OpenMUPP/openmupp-v1/openmupp-v1.kicad_pcb

## KiCad design openmupp-v1.kicad_pcb (2026-11-05)

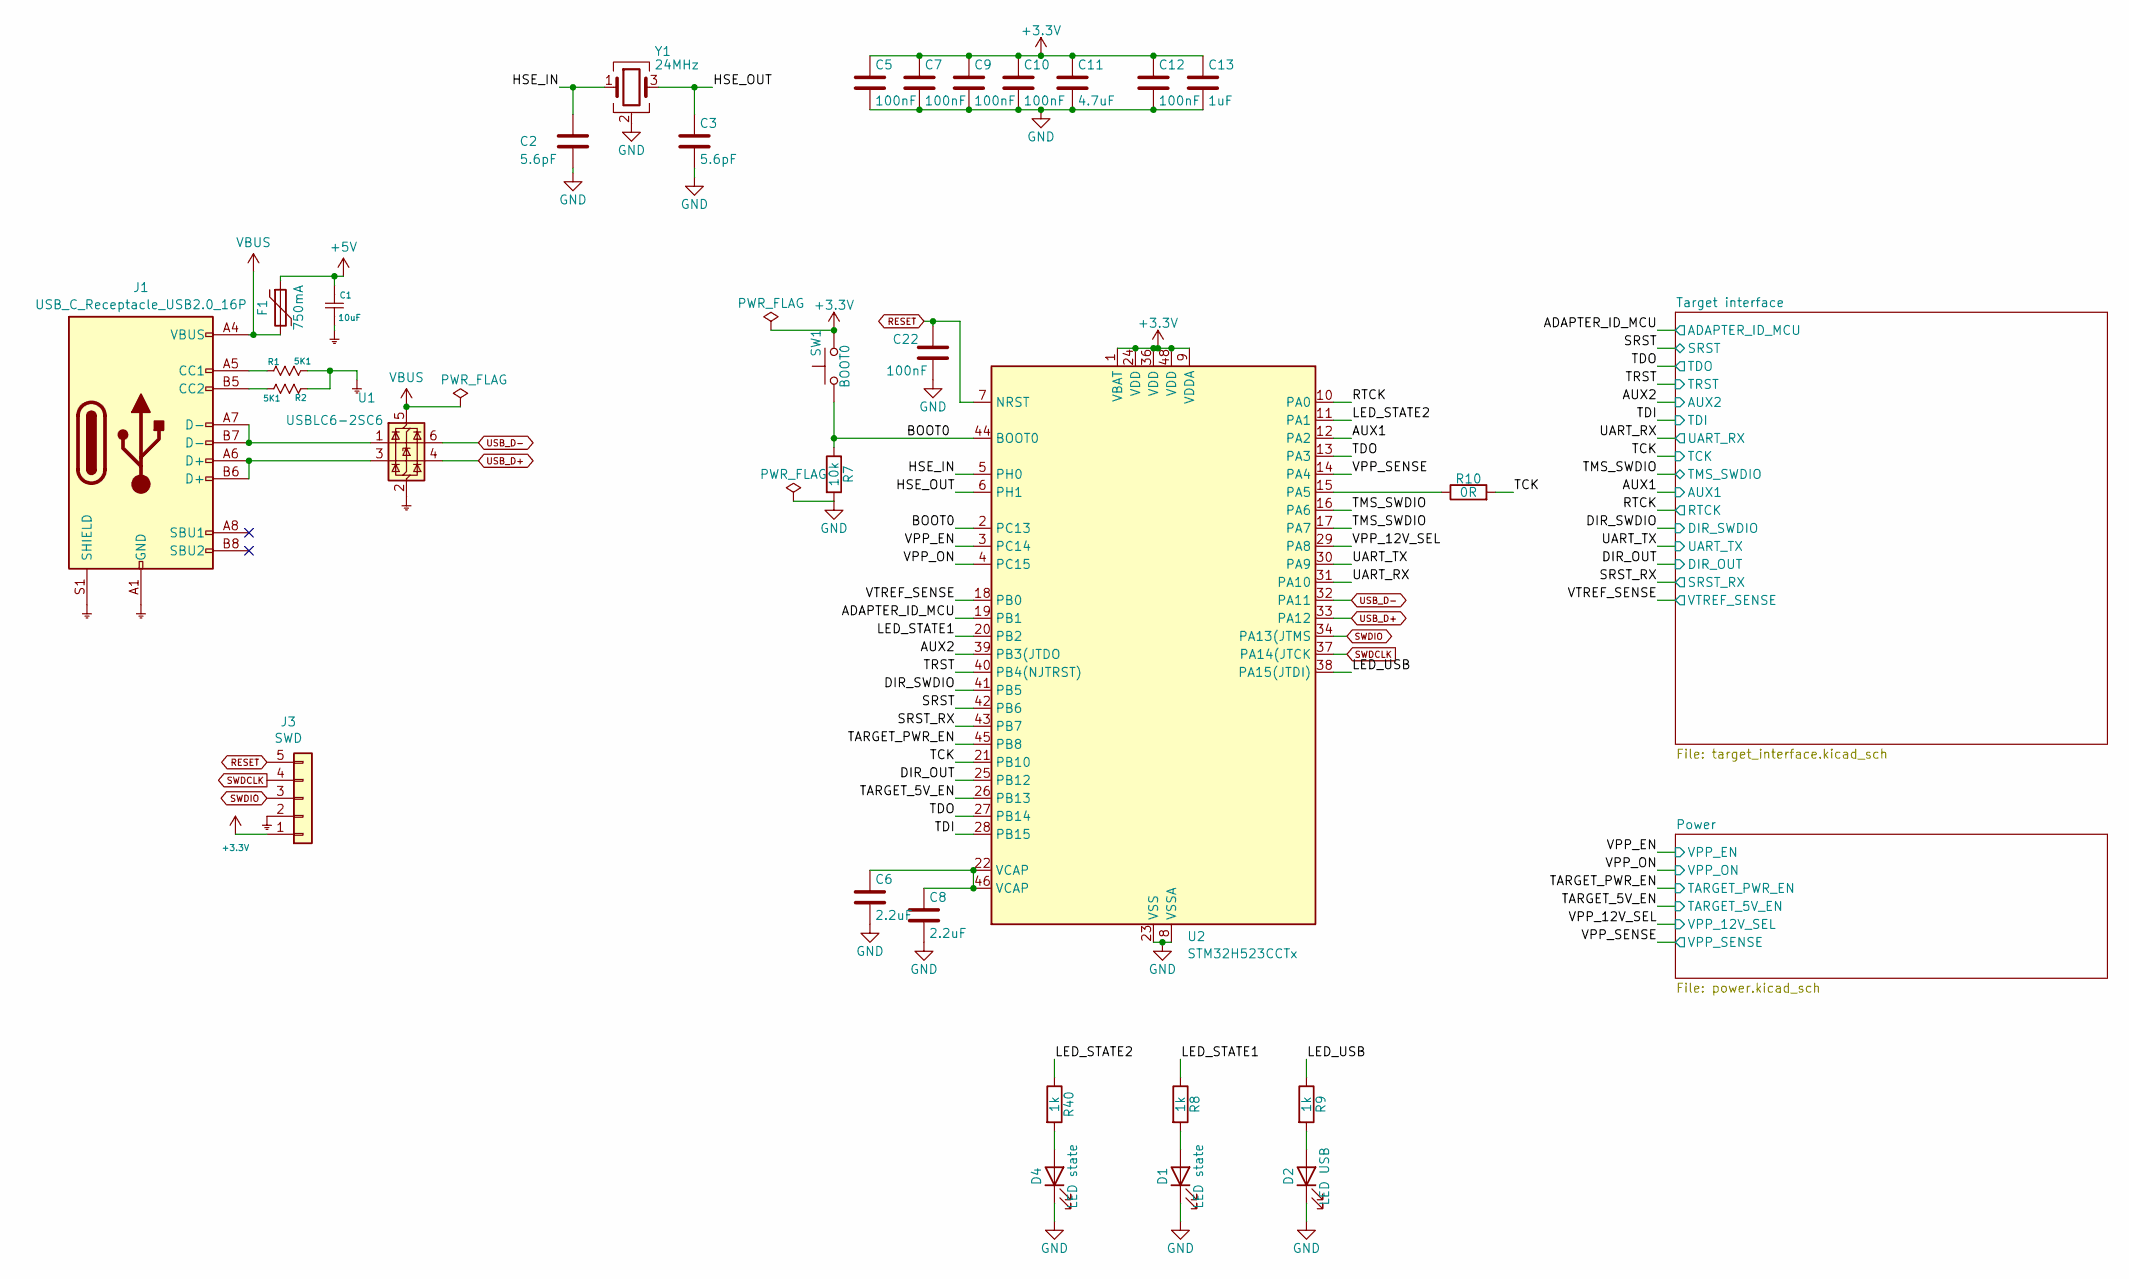
[picture p1: schematic openmupp-v1.kicad_sch]

Parts:
C1: 10uF; C_1206; VoltageRating 50V; LCSC C13585
C2, C3: 5.6pF; C_0402_1005Metric; LCSC C1574
C5, C7, C9, C10, C12, C22: 100nF; C_0603; LCSC C14663
C6, C8: 2.2uF; C_0603; LCSC C23630
C11: 4.7uF; C_0603; LCSC C19666
C13: 1uF; C_0603; LCSC C15849
D1, D4: LED state; LED_0603_1608Metric
D2: LED USB; LED_0603_1608Metric
F1: 750mA; Fuse_1206_3216Metric; LCSC C269118
J1: USB_C_Receptacle_USB2.0_16P; USB_C_Receptacle_HRO_TYPE-C-31-M-12; LCSC C165948
J3: SWD; CON_HDR_1x5_2.54mm
R1, R2: 5K1; R_0402; LCSC C25905
R7: 10k; R_0402; LCSC C25744
R8, R9, R40: 1k; R_0402; LCSC C11702
R10: 0R; R_0402; LCSC C17168
SW1: BOOT0; SW_Push_HanElectricity_TS1109_4.5x4.5mm_H3.8mm; LCSC C22375347
U1: USBLC6-2SC6; SOT-23-6; LCSC C7519
U2: STM32H523CCTx; LQFP-48_7x7mm_P0.5mm
Y1: 24MHz; Crystal_SMD_NDK_NX3225GA_3.2x2.5mm; MPN NX3225GA-24MHZ-STD-CRG-2; LCSC C156248

Connections:
/ADAPTER_ID_MCU: U2.19 (PB1); also elsewhere on the board
/AUX1: U2.12 (PA2); also elsewhere on the board
/AUX2: U2.39 (PB3(JTDO); also elsewhere on the board
/BOOT0: R7.1, SW1.1, U2.2 (PC13), U2.44 (BOOT0)
/DIR_OUT: U2.25 (PB12); also elsewhere on the board
/DIR_SWDIO: U2.41 (PB5); also elsewhere on the board
/HSE_IN: C2.1, U2.5 (PH0), Y1.1
/HSE_OUT: C3.1, U2.6 (PH1), Y1.3
/LED_STATE1: R8.1, U2.20 (PB2)
/LED_STATE2: R40.1, U2.11 (PA1)
/LED_USB: R9.1, U2.38 (PA15(JTDI))
/RTCK: U2.10 (PA0); also elsewhere on the board
/SRST: U2.42 (PB6); also elsewhere on the board
/SRST_RX: U2.43 (PB7); also elsewhere on the board
/TARGET_5V_EN: U2.26 (PB13); also elsewhere on the board
/TARGET_PWR_EN: U2.45 (PB8); also elsewhere on the board
/TCK: R10.2, U2.21 (PB10); also elsewhere on the board
/TDI: U2.28 (PB15); also elsewhere on the board
/TDO: U2.13 (PA3), U2.27 (PB14); also elsewhere on the board
/TMS_SWDIO: U2.16 (PA6), U2.17 (PA7); also elsewhere on the board
/TRST: U2.40 (PB4(NJTRST)); also elsewhere on the board
/UART_RX: U2.31 (PA10); also elsewhere on the board
/UART_TX: U2.30 (PA9); also elsewhere on the board
/VPP_12V_SEL: U2.29 (PA8); also elsewhere on the board
/VPP_EN: U2.3 (PC14); also elsewhere on the board
/VPP_ON: U2.4 (PC15); also elsewhere on the board
/VPP_SENSE: U2.14 (PA4); also elsewhere on the board
/VTREF_SENSE: U2.18 (PB0); also elsewhere on the board
unnamed: C6.1, C8.1, U2.22 (VCAP), U2.46 (VCAP)
unnamed: D1.2 (A), R8.2
unnamed: D2.2 (A), R9.2
unnamed: D4.2 (A), R40.2
unnamed: J1.A5 (CC1), R1.1
unnamed: J1.B5 (CC2), R2.2
unnamed: J1.A6 (D+), J1.B6 (D+), U1.3 (I/O2)
unnamed: J1.A7 (D-), J1.B7 (D-), U1.1 (I/O1)
unnamed: R10.1, U2.15 (PA5)
RESET: C22.1, J3.5, U2.7 (NRST)
SWDCLK: J3.4, U2.37 (PA14(JTCK)
SWDIO: J3.3, U2.34 (PA13(JTMS)
USB_D+: U1.4 (I/O2), U2.33 (PA12)
USB_D-: U1.6 (I/O1), U2.32 (PA11)

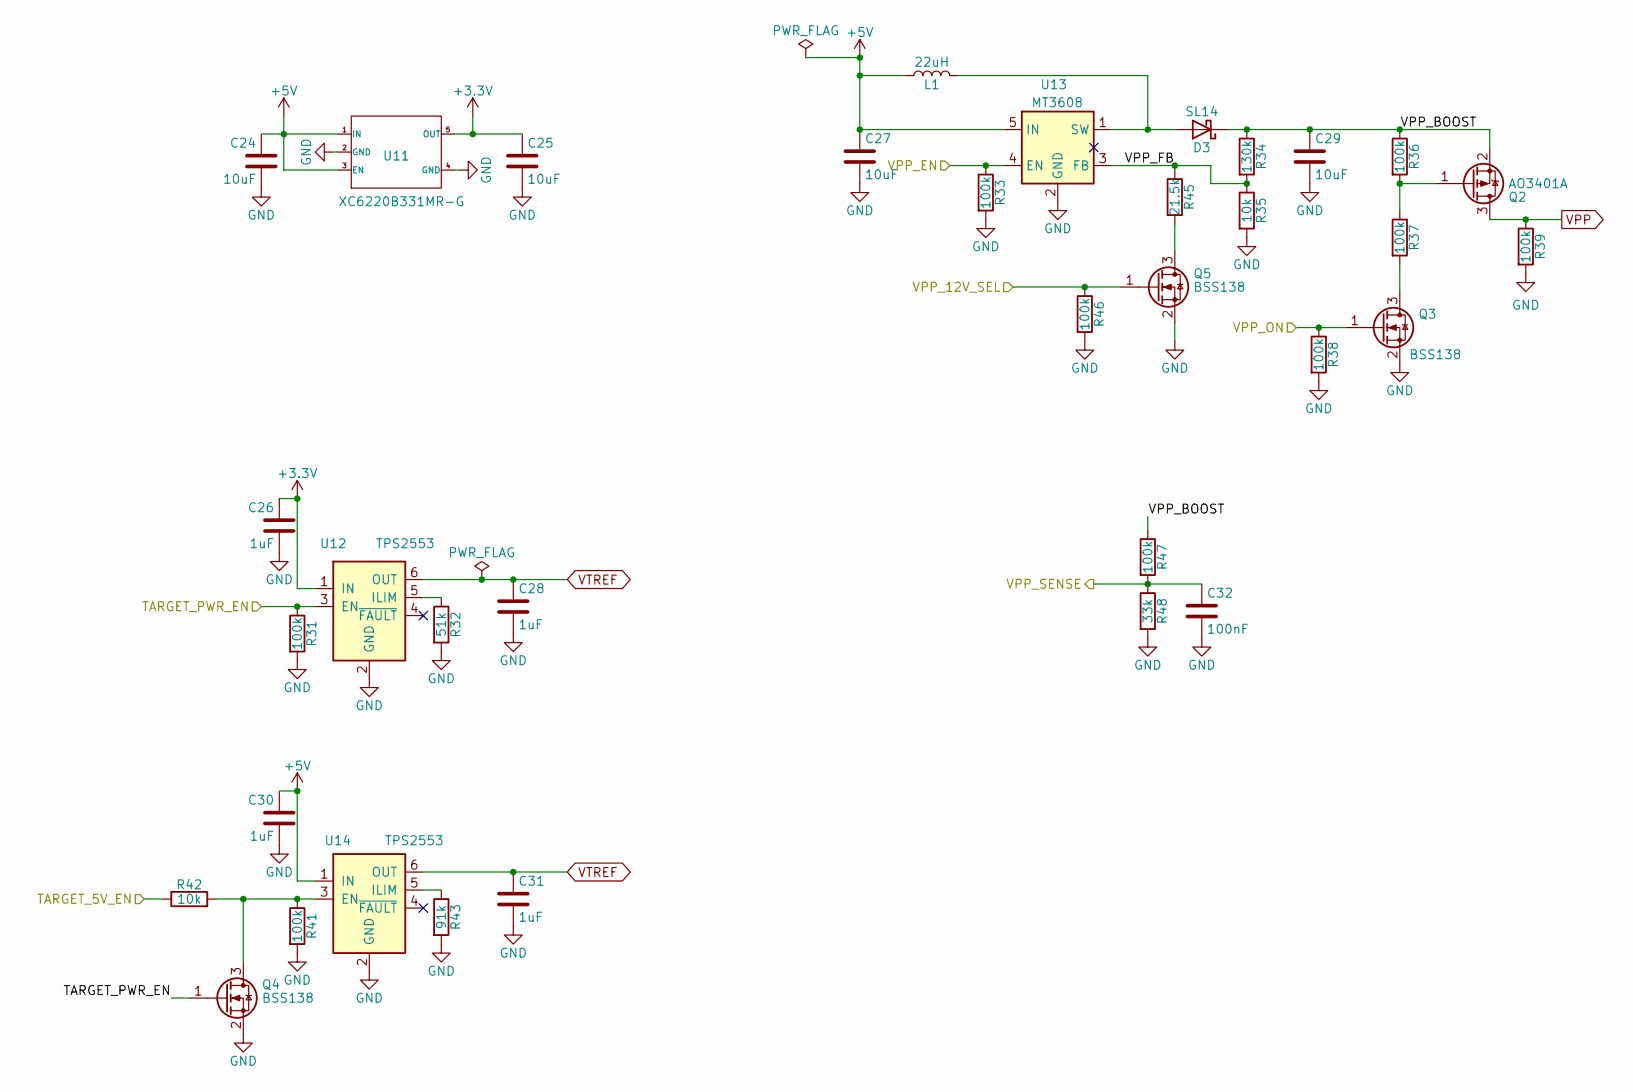
[picture p2: schematic power.kicad_sch]

Parts:
C24, C25: 10uF; C_1206; LCSC C13585
C26, C28, C30, C31: 1uF; C_0603; LCSC C15849
C27, C29: 10uF; C_0805; LCSC C15850
C32: 100nF; C_0603; LCSC C14663
D3: SL14; D_SMA; LCSC C698818
L1: 22uH; L_FNR5040S; LCSC C167971
Q2: AO3401A; SOT-23; LCSC C15127
Q3, Q4, Q5: BSS138; SOT-23; LCSC C112239
R31, R33, R36, R37, R38, R39, R41, R46, R47: 100k; R_0402; LCSC C25741
R32: 51k; R_0402; LCSC C25794
R34: 130k; R_0402; LCSC C52929
R35, R42: 10k; R_0402; LCSC C25744
R43: 91k; R_0603; LCSC C23265
R45: 21.5k; R_0402; LCSC C25872
R48: 33k; R_0402; LCSC C25779
U11: XC6220B331MR-G; SOT23_5L; LCSC C3040644
U12, U14: TPS2553; SOT-23-6; LCSC C111738
U13: MT3608; SOT23_6L; LCSC C84817

Connections:
/Power/VPP_BOOST: C29.1, D3.1 (K), Q2.2 (S), R34.1, R36.1, R47.1
/Power/VPP_FB: R34.2, R35.1, R45.1, U13.3 (FB)
/TARGET_5V_EN: R42.1; also elsewhere on the board
/TARGET_PWR_EN: Q4.1 (G), R31.1, U12.3 (EN); also elsewhere on the board
/VPP_12V_SEL: Q5.1 (G), R46.1; also elsewhere on the board
/VPP_EN: R33.1, U13.4 (EN); also elsewhere on the board
/VPP_ON: Q3.1 (G), R38.1; also elsewhere on the board
/VPP_SENSE: C32.1, R47.2, R48.1; also elsewhere on the board
unnamed: D3.2 (A), L1.2, U13.1 (SW)
unnamed: Q2.1 (G), R36.2, R37.1
unnamed: Q3.3 (D), R37.2
unnamed: Q4.3 (D), R41.1, R42.2, U14.3 (EN)
unnamed: Q5.3 (D), R45.2
unnamed: R32.1, U12.5 (ILIM)
unnamed: R43.1, U14.5 (ILIM)
VPP: Q2.3 (D), R39.1; also elsewhere on the board

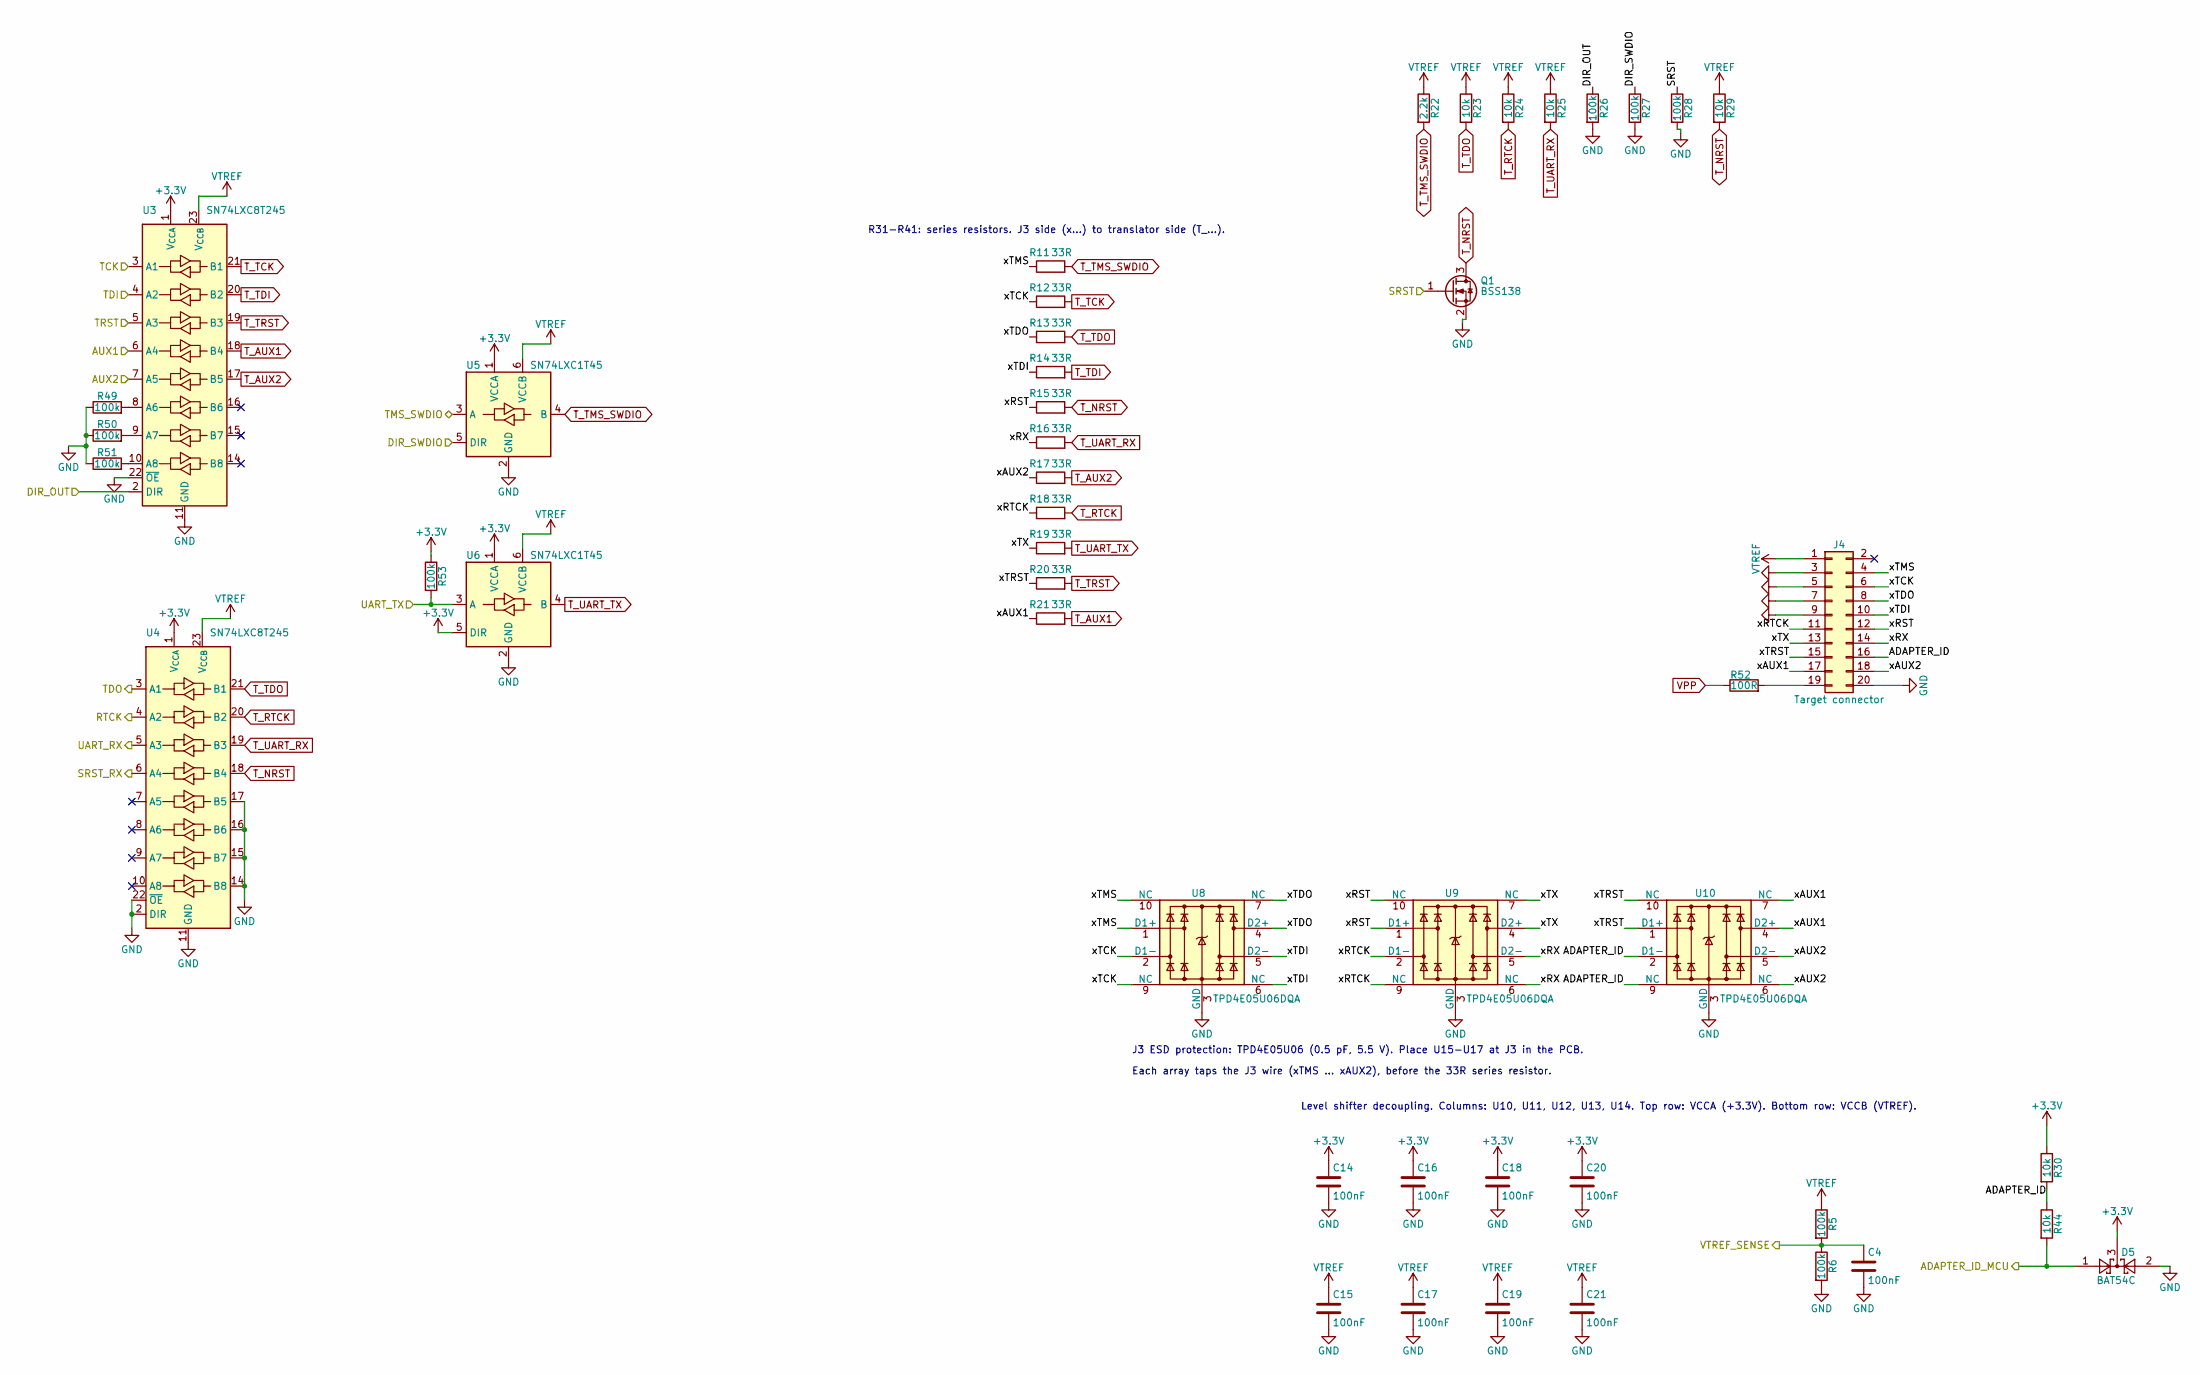
[picture p3: schematic target_interface.kicad_sch]

Parts:
C4, C14, C15, C16, C17, C18, C19, C20, C21: 100nF; C_0603; LCSC C14663
D5: BAT54C; SOT-23; LCSC C37704
J4: Target connector; IDC-Header_2x10_P2.54mm_Horizontal
Q1: BSS138; SOT-23; LCSC C112239
R5, R6, R26, R27, R28, R49, R50, R51, R53: 100k; R_0402; LCSC C25741
R11, R12, R13, R14, R15, R16, R17, R18, R19, R20, R21: 33R; R_0402; LCSC C25105
R22: 2.2k; R_0402; LCSC C25879
R23, R24, R25, R29, R30, R44: 10k; R_0402; LCSC C25744
R52: 100R; R_0402; LCSC C25076
U3, U4: SN74LXC8T245; TSSOP-24_4.4x7.8mm_P0.65mm; LCSC C4363995
U5, U6: SN74LXC1T45; SOT-23-6; LCSC C4364198
U8, U9, U10: TPD4E05U06DQA; USON-10_2.5x1.0mm_P0.5mm; LCSC C138714

Connections:
/ADAPTER_ID_MCU: D5.1, R44.2; also elsewhere on the board
/AUX1: U3.6 (A4); also elsewhere on the board
/AUX2: U3.7 (A5); also elsewhere on the board
/DIR_OUT: R26.1, U3.2 (DIR); also elsewhere on the board
/DIR_SWDIO: R27.1, U5.5 (DIR); also elsewhere on the board
/RTCK: U4.4 (A2); also elsewhere on the board
/SRST: Q1.1 (G), R28.1; also elsewhere on the board
/SRST_RX: U4.6 (A4); also elsewhere on the board
/TCK: U3.3 (A1); also elsewhere on the board
/TDI: U3.4 (A2); also elsewhere on the board
/TDO: U4.3 (A1); also elsewhere on the board
/TMS_SWDIO: U5.3 (A); also elsewhere on the board
/TRST: U3.5 (A3); also elsewhere on the board
/Target interface/ADAPTER_ID: J4.16, R30.2, R44.1, U10.2 (D1-), U10.9 (NC)
/Target interface/xAUX1: J4.17, R21.1, U10.4 (D2+), U10.7 (NC)
/Target interface/xAUX2: J4.18, R17.1, U10.5 (D2-), U10.6 (NC)
/Target interface/xRST: J4.12, R15.1, U9.1 (D1+), U9.10 (NC)
/Target interface/xRTCK: J4.11, R18.1, U9.2 (D1-), U9.9 (NC)
/Target interface/xRX: J4.14, R16.1, U9.5 (D2-), U9.6 (NC)
/Target interface/xTCK: J4.6, R12.1, U8.2 (D1-), U8.9 (NC)
/Target interface/xTDI: J4.10, R14.1, U8.5 (D2-), U8.6 (NC)
/Target interface/xTDO: J4.8, R13.1, U8.4 (D2+), U8.7 (NC)
/Target interface/xTMS: J4.4, R11.1, U8.1 (D1+), U8.10 (NC)
/Target interface/xTRST: J4.15, R20.1, U10.1 (D1+), U10.10 (NC)
/Target interface/xTX: J4.13, R19.1, U9.4 (D2+), U9.7 (NC)
/UART_RX: U4.5 (A3); also elsewhere on the board
/UART_TX: R53.2, U6.3 (A); also elsewhere on the board
/VTREF_SENSE: C4.1, R5.2, R6.1; also elsewhere on the board
unnamed: J4.19, R52.2
unnamed: R49.2, U3.8 (A6)
unnamed: R50.2, U3.9 (A7)
unnamed: R51.2, U3.10 (A8)
T_AUX1: R21.2, U3.18 (B4)
T_AUX2: R17.2, U3.17 (B5)
T_NRST: Q1.3 (D), R15.2, R29.2, U4.18 (B4)
T_RTCK: R18.2, R24.2, U4.20 (B2)
T_TCK: R12.2, U3.21 (B1)
T_TDI: R14.2, U3.20 (B2)
T_TDO: R13.2, R23.2, U4.21 (B1)
T_TMS_SWDIO: R11.2, R22.2, U5.4 (B)
T_TRST: R20.2, U3.19 (B3)
T_UART_RX: R16.2, R25.2, U4.19 (B3)
T_UART_TX: R19.2, U6.4 (B)
VPP: R52.1; also elsewhere on the board

Notes on the sheet:
J3 ESD protection: TPD4E05U06 (0.5 pF, 5.5 V). Place U15-U17 at J3 in the PCB.
Each array taps the J3 wire (xTMS ... xAUX2), before the 33R series resistor.
R31-R41: series resistors. J3 side (x...) to translator side (T_...).
Level shifter decoupling. Columns: U10, U11, U12, U13, U14. Top row: VCCA (+3.3V). Bottom row: VCCB (VTREF).

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
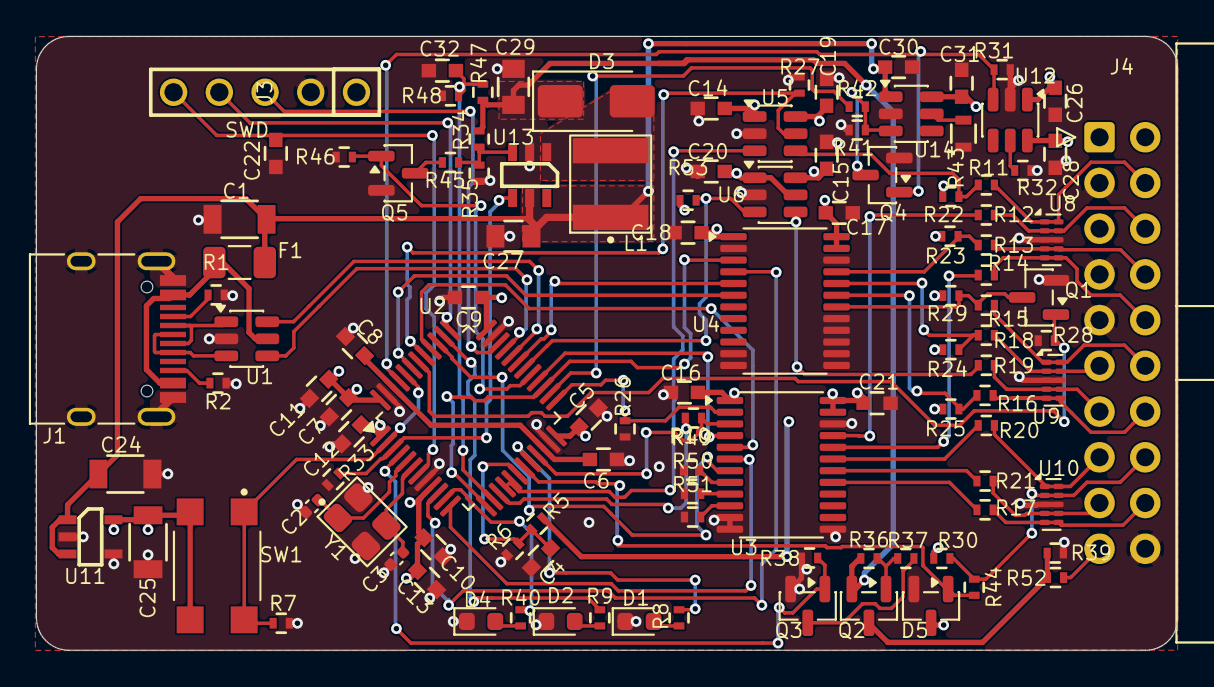
[picture p4: board openmupp-v1.kicad_pcb from above]

Board: 4 copper layers, 63.4 x 34.1 mm, 112 parts (0 on the bottom side), 84 nets.
