OpenMUPP/openmupp-v1/(commit log)

2026-10-14 Initial files
    [versaloon-ng.kicad_pcb, versaloon-ng.kicad_sch]
2026-10-19 feature: add USB D+/D- series resistors and connect USB to MCU
    Previous schematic edits are included in this commit. Add R19/R20
    (22R) between the USBLC6 ESD diode and the STM32 PA11/PA12 pins.
    [versaloon-ng.kicad_sch]
2026-10-19 feature: wire STLink V3 connector to MCU and set global label directions
    Connect PA15 (JTDI) and PB3 (JTDO) to the STLink V3 connector, and
    set input/output/bidirectional shapes on the SWD, JTAG and USB labels.
    [versaloon-ng.kicad_sch]
2026-10-19 feature: add BOOT0 push button with pull-down
    SW1 pulls BOOT0 to +3.3V when pressed. R21 (10k) holds it low otherwise.
    [versaloon-ng.kicad_sch]
2026-10-19 feature: connect MCU supply pins and add decoupling capacitors
    Wire VDD, VDDA, VBAT to +3.3V and VSS/VSSA to GND. Add 5x 100nF,
    4.7uF bulk, 1uF on VDDA and 2x 2.2uF on VCAP as per AN5711.
    [versaloon-ng.kicad_sch]
2026-10-19 chore: resave project from KiCad
    [versaloon-ng.kicad_sch]
2026-10-19 feature: add target level shifters and connect them to the MCU
    Ten SN74LXC1T45 translators (VCCA 3.3V, VCCB VTREF) for TCK, TDI, TRST,
    AUX1, AUX2 (DIR_OUT), SWDIO (DIR_SWDIO), UART TX, and fixed-direction
    TDO, RTCK, UART RX. BSS138 open-drain path for nRESET, B-side pull-ups
    and DIR pull-downs, 100nF bypass on each supply pin. MCU pins follow the
    NB-H1 pin map. Sheet size changed to A3.
    [versaloon-ng.kicad_sch]
2026-10-19 refactor: use multi-channel level translators
    Replace the ten single-channel translators by one 8-bit part for the
    DIR_OUT group (TCK, TDI, TRST, AUX1, AUX2), one 2-bit part for the fixed
    inputs TDO and RTCK, and three single-bit parts for SWDIO, UART TX and
    UART RX. Bypass capacitors drop from 20 to 10.
    [versaloon-ng.kicad_sch]
2026-10-19 refactor: use power symbols and group the translator decoupling caps
    Replace the +3.3V, GND and VTREF global labels in the level shifter
    block by power symbols, as on the rest of the sheet. Move the ten
    bypass capacitors into one group below the translators.
    [versaloon-ng.kicad_sch]
2026-10-19 chore: resave schematic from KiCad
    [versaloon-ng.kicad_sch]
2026-10-19 feature: add generic 20-pin target connector with series resistors
    Replace the STLINK V3 target header with one 2x10 2.54 mm shrouded
    header for passive adapter boards. Pinout: VTREF, VTPWR, SWDIO/TMS,
    TCK, TDO, TDI, RTCK, nRESET, UART TX/RX, TRST, AUX1, AUX2, VPP,
    ADAPTER_ID and five GND pins.
    - 33R series resistor (R31-R41) on each of the 11 signal lines, between
    the connector and the level translators.
    - ADAPTER_ID goes to PB1 (ADC) with a 10k pull-up to 3.3V (R30).
    - VTPWR and VPP are labels only: nothing drives them yet.
    The diff is large because the file was written by a tool that puts each
    coordinate on its own line. The design content is unchanged apart from
    the items above.
    [versaloon-ng.kicad_sch]
2026-10-19 feature: add ESD protection on the target connector
    Add three TPD4E05U06 4-channel ESD arrays (U15-U17) on the 12 logic
    lines of the 20-pin target connector: TMS/SWDIO, TCK, TDO, TDI, nRESET,
    UART RX/TX, RTCK, TRST, AUX1, AUX2 and ADAPTER_ID. The arrays have no
    supply pin, so ADAPTER_ID (pulled up to 3.3V) cannot back-feed VTREF.
    Each array taps the wire between the connector and the 33R series
    resistor, on short local nets (xTMS ... xAUX2). Shift the connector
    block 7.6 mm left to make room for those nets. VTPWR and VPP have no
    protection yet: they need a part rated above 5.5V.
    [versaloon-ng.kicad_sch]
2026-10-19 refactor: move the target interface to its own sheet
    Move the target-side circuit from the main sheet to the new sheet
    target_interface.kicad_sch ("Target interface"):
    - the 20-pin target connector J3 and its ADAPTER_ID pull-up
    - the level shifters U10-U14 with their decoupling and pull resistors
    - the nRESET MOSFET Q1
    - the ESD arrays U15-U17
    - the 33R series resistors R31-R41
    The main sheet keeps the MCU, the USB, the crystal, the regulator and
    the probe headers. 14 sheet pins carry the MCU-side nets: TCK, TDI,
    TDO, TMS_SWDIO, TRST, RTCK, AUX1, AUX2, DIR_OUT, DIR_SWDIO, UART_TX,
    UART_RX, SRST and ADAPTER_ID. Power nets stay global.
    The series resistors now sit in one column, so their re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
    [target_interface.kicad_sch, versaloon-ng.kicad_sch]
2026-10-19 feature: add VTREF sense, state and USB LEDs, share the key with BOOT0
    - VTREF sense on PB0 (ADC): 100k/100k divider (R42, R43) with a 100nF
    filter capacitor (C30). It covers targets up to 5.5V.
    - LED state (D8, PB2) and LED USB (D9, PB5): active high, 1k series
    resistors (R44, R45).
    - The key on PC13 shares the BOOT0 switch SW1. PC13 reads the BOOT0 net,
    so the firmware sees the button while it runs. A press at power-up
    still enters the ROM bootloader.
    Not added yet: the power LED on PA15 (PA15 is JTDI on the probe debug
    header J2) and the target power switch on PB8.
    [versaloon-ng.kicad_sch]
2026-10-19 feature: add a debug UART to the STLINK V3 header
    Connect LPUART1 (PB6 TX, PB7 RX, AF8) to pins 14 and 13 of the probe's
    STLINK V3 header J2. The probe firmware can send debug output through
    the VCP of an STLINK V3 that debugs the probe. USART1 stays on the
    target UART.
    [versaloon-ng.kicad_sch]
2026-10-20 chore: resave target interface sheet and project in KiCad 10 format
    The file rewrite reorders items and bumps the format version.
    The BSS138 on the SRST path also gets its LCSC part number.
    [target_interface.kicad_sch]
2026-10-20 feature: add power sheet with LDO, 12 V boost and switched VPP
    Move the 3.3 V LDO and its capacitors to a new Power sheet.
    Add an MT3608 boost converter (about 12 V) fed from the 5 V rail.
    Gate the boost output with a P-channel switch (VPP_EN, VPP_ON), so VPP
    stays at 0 V unless both control lines are high. VPP joins the existing
    global label on the target interface sheet.
    The root sheet also carries the KiCad 10 format rewrite.
    [power.kicad_sch, versaloon-ng.kicad_sch]
2026-10-20 feature: connect VPP_EN and VPP_ON to PC14 and PC15
    [versaloon-ng.kicad_sch]
2026-10-20 feature: add project symbol library with TPS2553 load switch
2026-10-20 feature: add current-limited target power switch on PB8
    Switch the 3.3 V rail to the VTPWR net with a TPS2553, limited to about
    500 mA by a 51k resistor. TARGET_PWR_EN (PB8) enables it, and a 100k
    pull-down keeps it off while the MCU is in reset.
    [power.kicad_sch, versaloon-ng.kicad_sch]
2026-10-20 fix: enlarge the TPS2553 symbol body so the pin names fit
    The GND pin moves down, so its power symbol moves with it.
    [power.kicad_sch]
2026-10-20 feature: use the target power switch as the VTREF source/sense selector
    The TPS2553 output now joins the VTREF net. With the switch off, VTREF
    senses the target supply. With the switch on, the probe supplies the
    target at 3.3 V. The output capacitor drops to 1 uF to limit the load on
    a self-powered target.
    [power.kicad_sch]
2026-10-20 feature: add a resettable fuse on the USB VBUS input
    A 750 mA hold PTC sits between the USB-C VBUS pins and the rest of the
    board, ahead of the ESD protection and the 5 V diode.
    [versaloon-ng.kicad_sch]
2026-10-20 feature: use a shielded 22uH inductor for the boost converter
    [power.kicad_sch]
2026-10-20 fix: add a footprint that matches the FNR5040S inductor pads
    [power.kicad_sch]
2026-10-20 fix: take the FNR5040S footprint from the shared inductors library
    [power.kicad_sch]
2026-10-20 feature: set LCSC part numbers on the level shifters
    Use the SN74LXC variants that match the part values: 8T245 in TSSOP-24, 2T45 in VSSOP-8 and 1T45 in SOT-23-6.
    [target_interface.kicad_sch]
2026-10-20 chore: let KiCad reorder the used designator list
2026-10-20 chore: let KiCad reformat the root sheet
    Library symbol and property order changes only. No electrical change.
    [versaloon-ng.kicad_sch]
2026-10-20 fix: reserve J3 pin 2 instead of the undriven VTPWR net
    The TPS2553 output is VTREF, so J3 pin 1 already carries the target
    supply. Replace the dangling VTPWR label with a no-connect flag.
    [target_interface.kicad_sch]
2026-10-20 docs: describe J3 as the only target connector in project instructions
    J2 and J4 only debug the probe MCU. Replace the aux header open item
    with the TCK link and the list of unconnected pins.
2026-10-20 feature: add DNP 0R link R55 for TCK and remove diode D7
    R55 (DNP) joins the TCK net on the root sheet for the JTAG fast path.
    D7 (SL14) and its VBUS power symbol are removed. KiCad also reordered
    used_designators in the project file.
    [versaloon-ng.kicad_sch]
2026-10-20 fix: add no-connect flags and PWR_FLAG symbols for ERC
    [power.kicad_sch, versaloon-ng.kicad_sch]
2026-10-20 fix: tie J2 and J4 VTref to +3.3V instead of the separate V3 net
    [versaloon-ng.kicad_sch]
2026-10-21 Update footprints and parts
    [power.kicad_sch, target_interface.kicad_sch, versaloon-ng.kicad_sch]
2026-10-21 refactor: switch resistors to 0402 and set basic-library LCSC numbers
    [power.kicad_sch, target_interface.kicad_sch, versaloon-ng.kicad_sch]
2026-10-21 refactor: use smaller XUNPU TS-1088 tact switch for SW1 (BOOT0)
    [versaloon-ng.kicad_sch]
2026-10-21 refactor: use 4.5x4.5 mm HanElectricity TS1109 tact switch for SW1
    [versaloon-ng.kicad_sch]
2026-10-21 Some placement
    [versaloon-ng.kicad_pcb]
2026-10-22 Start routing
    [target_interface.kicad_sch, versaloon-ng.kicad_pcb]
2026-10-23 Add extra status led
    [versaloon-ng.kicad_sch]
2026-10-23 Plae refernces
    [versaloon-ng.kicad_pcb]
2026-10-23 Fix DRC
    [versaloon-ng.kicad_pcb]
2026-10-31 refactor: rename project from versaloon-ng to openmupp-v1
    Rename the KiCad project files and the project symbol library.
    Update project names in sheet instances, PCB sheetfile references,
    lib_id, sym-lib-table, README and CLAUDE.md.
    [openmupp-v1.kicad_pcb, openmupp-v1.kicad_sch, power.kicad_sch, target_interface.kicad_sch]
2026-10-31 feature: move DIR_SWDIO to PB5 (TIM3_CH2) and LED_USB to PA15
    Frees PA8 and PB3. J2 JTDI and JTDO/SWO are no longer connected
    because the probe MCU is not debugged over JTAG. Refs #1.
    [openmupp-v1.kicad_sch]
2026-10-31 feature: change SWDIO pull-up R22 from 10k to 2.2k
    The one-wire interface needs the line to rise fast after the target
    releases it. Refs #1.
    [target_interface.kicad_sch]
2026-10-31 feature: remove probe debug header J2 and C30
    J2 (STDC14) is no longer needed. PB6/PB7 (DBG_TX/DBG_RX) become unused.
    power.kicad_sch only gains the re-saved TPS2553 symbol cache.
    [openmupp-v1.kicad_sch, power.kicad_sch]
2026-10-31 feature: update PCB netlist for the PA15/PB5 swap and J2 removal
    Applies the R22 2.2k value, the DIR_SWDIO/LED_USB pin swap and the
    J2/C30 removal to the board.
    [openmupp-v1.kicad_pcb]
2026-10-31 Update pcb
    [openmupp-v1.kicad_pcb]
2026-10-31 Resize labels
    [openmupp-v1.kicad_sch]
2026-10-31 feature: split nRESET into low-side TX FET and U4 read-back
    Q1 now pulls nRESET low from GND, driven by PB6 (LPUART1_TX). U4, a new
    SN74LXC8T245, replaces the 2-channel and 1-channel shifters for TDO,
    RTCK and UART RX, and adds nRESET read-back on PB7 (LPUART1_RX).
    R28 becomes a 100k gate pull-down. PB10 is now unused.
    [openmupp-v1.kicad_sch, target_interface.kicad_sch]
2026-10-31 docs: explain why UART TX has its own level shifter
2026-10-31 fix: renumber new power symbols to avoid duplicates on the root sheet
    #PWR01, #PWR02, #PWR06 and #PWR07 on the target interface sheet clashed
    with the same references on the root sheet, which broke the PCB update.
    [target_interface.kicad_sch]
2026-10-31 Update routing
    [openmupp-v1.kicad_pcb]
2026-10-31 feature: add 5 V target switch U14 with 3.3 V priority interlock
    [power.kicad_sch]
2026-10-31 feature: wire TARGET_5V_EN to PB10, protect ADAPTER_ID with R44 and D5
    [openmupp-v1.kicad_sch]
2026-10-31 docs: describe 5 V target supply and ADAPTER_ID clamp
2026-10-31 fix: set LCSC parts for R43 and D5
    [openmupp-v1.kicad_sch, power.kicad_sch]
2026-10-31 Placement & routing of the selectable 3.3V and 5V Vout feature
    [openmupp-v1.kicad_pcb, openmupp-v1.kicad_sch, power.kicad_sch]
2026-10-31 Improved placement
    [openmupp-v1.kicad_pcb]
2026-10-31 feature: select 8.4 V or 12 V VPP with VPP_12V_SEL (PA8)
    R34 becomes 130k for the 8.4 V default. Q5 with R45 (21.5k) in parallel with R35 selects 12 V. R46 pulls the gate low. Refs #4.
    [openmupp-v1.kicad_sch, power.kicad_sch]
2026-10-31 chore: save KiCad editor changes to schematics
    [openmupp-v1.kicad_sch, power.kicad_sch]
2026-10-31 refactor: move ADAPTER_ID clamp and VTREF divider to target sheet
    R44, D5, R5, R6 and C4 move from the root sheet to the target interface sheet. The sheet pin ADAPTER_ID becomes ADAPTER_ID_MCU. New sheet pin VTREF_SENSE. Net names and reference designators stay the same.
    [openmupp-v1.kicad_sch, target_interface.kicad_sch]
2026-10-31 docs: note sense circuits on the target interface sheet
2026-10-31 feature: add VPP_SENSE divider on PA4, move AUX2 to PB3
    R47 and R48 divide the boost output for the ADC. C32 filters the pin. AUX2 moves from PA4 to PB3. Refs #4.
    [openmupp-v1.kicad_sch, power.kicad_sch]
2026-10-31 docs: describe VPP_SENSE and the AUX2 pin change
2026-10-31 fix: give new power symbols unique reference designators
    Eight power symbols added in the VPP and sense changes reused #PWR01-#PWR07. They now use #PWR0130-#PWR0137. The working copy also holds the KiCad editor's save format for the schematics.
    [openmupp-v1.kicad_sch, power.kicad_sch, target_interface.kicad_sch]
2026-10-31 Fix problems with VPP schematics
    [openmupp-v1.kicad_sch, power.kicad_sch, target_interface.kicad_sch]
2026-10-31 Placement and routing of VPP selection components
    [openmupp-v1.kicad_pcb]
2026-10-31 docs: correct README and CLAUDE.md against the schematic netlist
2026-11-01 docs: remove the private footprint library from the setup
2026-11-01 docs: drop the schematic mismatch note for R34 from the VPP section
2026-11-01 docs: allow passive high-voltage adapters
    The VPP circuitry is now on the main board, so the adapter needs no
    protection parts of its own.
2026-11-04 Fix review issues
    [openmupp-v1.kicad_pcb, openmupp-v1.kicad_sch, power.kicad_sch, target_interface.kicad_sch]
2026-11-04 fix: make TPS2553 OUT pin passive for ERC
    U12 and U14 both drive VTREF. Two power_out pins on one net and the
    PWR_FLAG on VTREF gave two ERC errors. The OUT pin is now passive, so
    the PWR_FLAG marks VTREF as driven.
    [power.kicad_sch]
2026-11-04 docs: update pin map for PB10/PB13 swap
2026-11-04 docs: name U5 as the SWDIO shifter in the pin map
2026-11-04 fix: correct R34 LCSC and fill missing LCSC numbers
    R34 is 130k but still had the 191k part (C270632); use C52929.
    Fill the LCSC field of 28 more parts. Each number is checked against
    the JLCPCB parts database for value and package. D1, D2, D4, J3, J4
    and U2 stay empty: LED colour, connector part and STM32H523CCT6 stock
    need a decision.
    [openmupp-v1.kicad_sch, power.kicad_sch, target_interface.kicad_sch]
2026-11-05 Fix drc and review issues
    [openmupp-v1.kicad_pcb, openmupp-v1.kicad_sch, power.kicad_sch, target_interface.kicad_sch]
