OpenMUPP/openmupp-v1/(notices)

Notices in the files:
parts and their libraries:
copyright: 2018 Armin van der Togt
